kevprakoso/TA161701069/README.md

# TA161701069

Merupakan dokumentasi Tugas Akhir dari kelompok TA161701069 Program Studi Teknik Elektro Institut Teknologi Bandung, beranggotakan:

Christoporus Deo Putratama

Kevin Shidqi Prakoso

Bramantio Yuwono
