kevprakoso/TA161701069/swarm-2.6.2/mapdata/augustine/augustine_10m.png

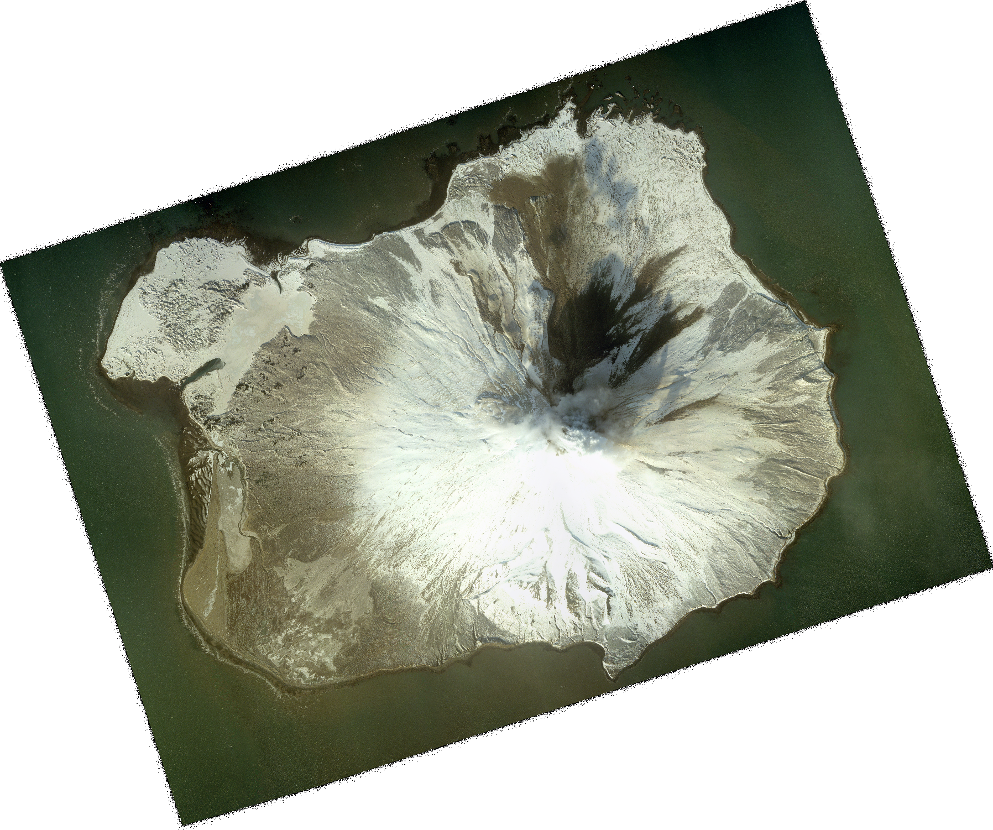
swarm-2.6.2/mapdata/augustine/augustine_10m.png
