kevprakoso/TA161701069/swarm-2.6.2/mapdata/nasa_2k/nasa_2k_B_10.jpg

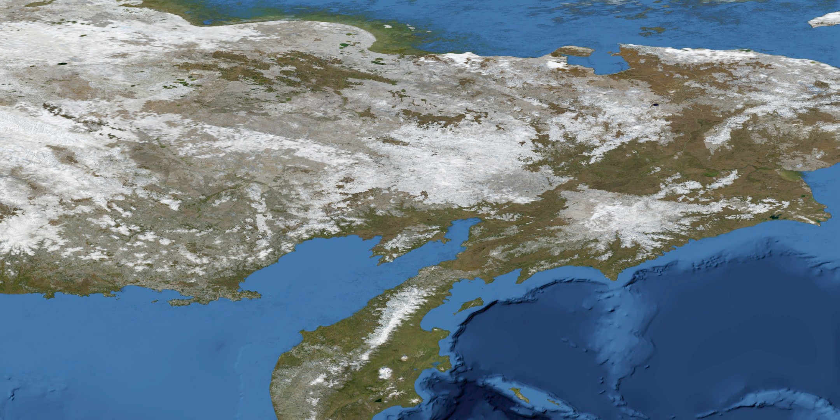
swarm-2.6.2/mapdata/nasa_2k/nasa_2k_B_10.jpg
