kevprakoso/TA161701069/swarm-2.6.2/mapdata/nasa_240m_A1/nasa_240m_A1_F_07.jpg

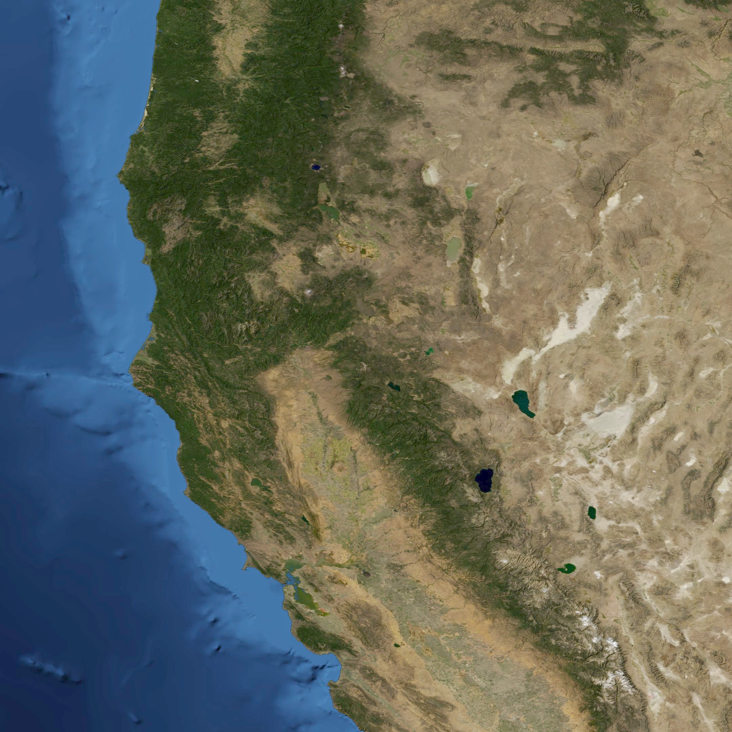
swarm-2.6.2/mapdata/nasa_240m_A1/nasa_240m_A1_F_07.jpg
