kevprakoso/TA161701069/swarm-2.6.2/mapdata/nasa_240m_D2/nasa_240m_D2_E_10.jpg

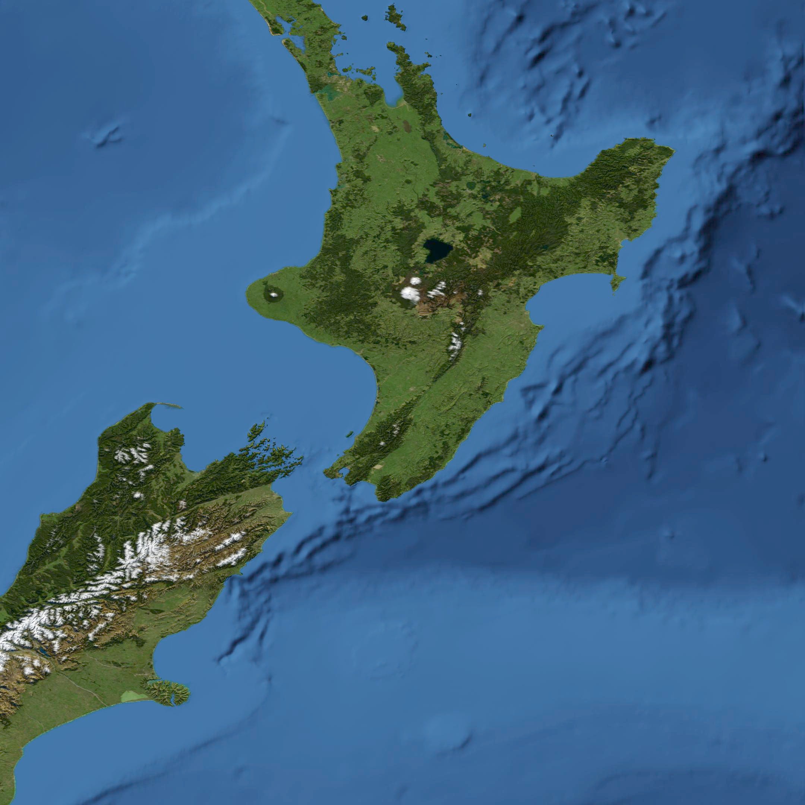
swarm-2.6.2/mapdata/nasa_240m_D2/nasa_240m_D2_E_10.jpg
