kevprakoso/TA161701069/swarm-2.6.2/mapdata/world/world_B2.jpg

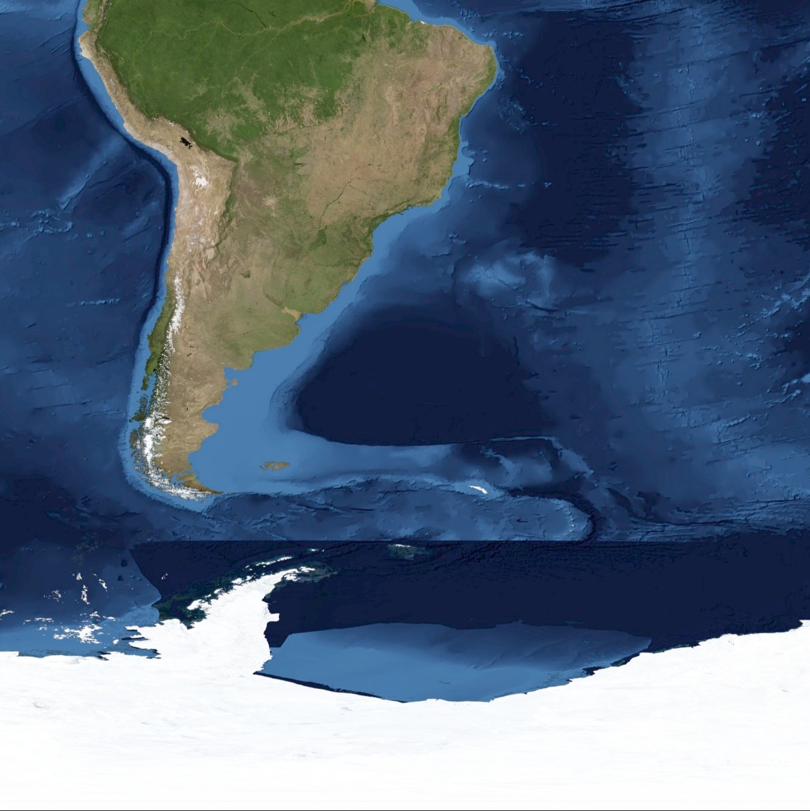
swarm-2.6.2/mapdata/world/world_B2.jpg
