kevprakoso/TA161701069/(commit log)

2017-02-12 Update ECNtest Arduino 12-2-2017
2017-02-19 Added Multi-threading
